xSYOTOSx/EPHSX601/README.md

# EPHSX601

This is a repository for the EPHSX601 project, which is an Arduino-based program designed to control a set of LED boards using a custom protocol over serial communication.
