xSYOTOSx/EPHSX601/EPHSX601_FinalP.pdf

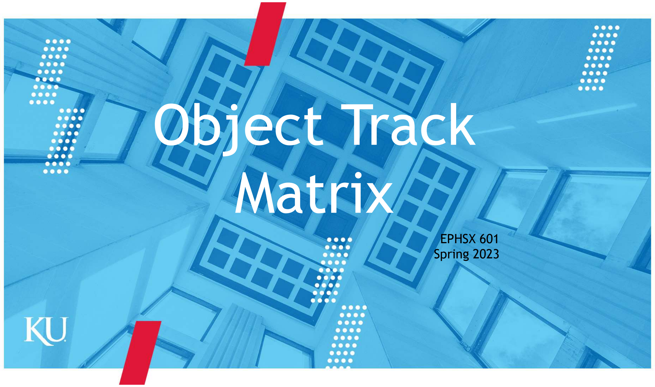
[picture p3: page 1]

# Object Track Matrix

EPHSX 601
Spring 2023

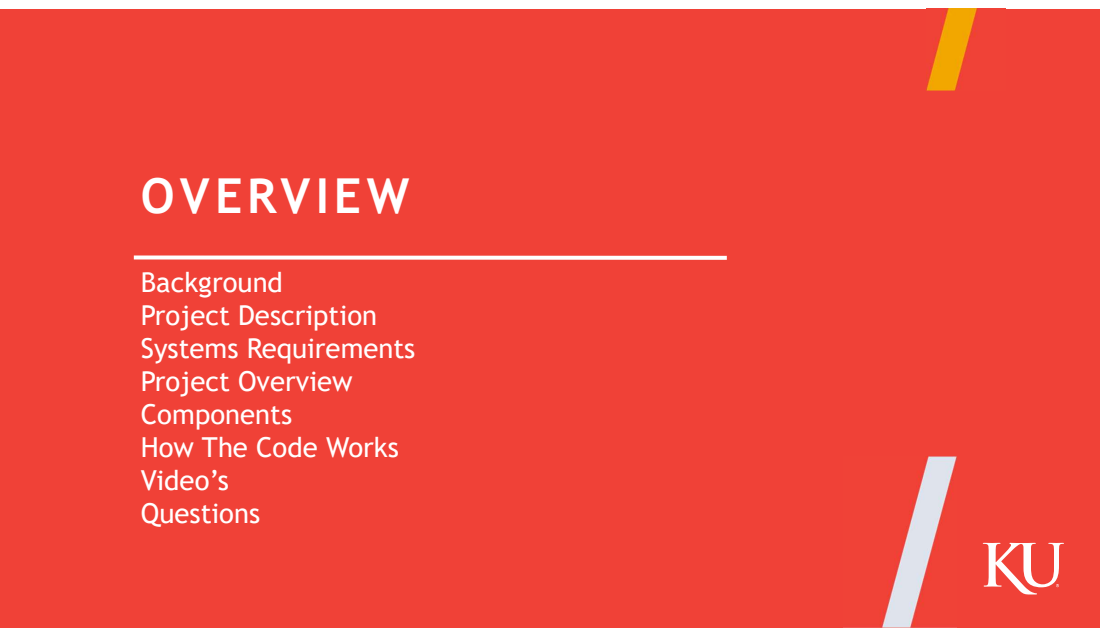
[picture p4: page 2]
OVERVIEW

Background
Project Description
Systems Requirements
Project Overview
Components
How The Code Works
Video’s
Questions

•••••••••••••••••••••••••••••••••

# Back Ground

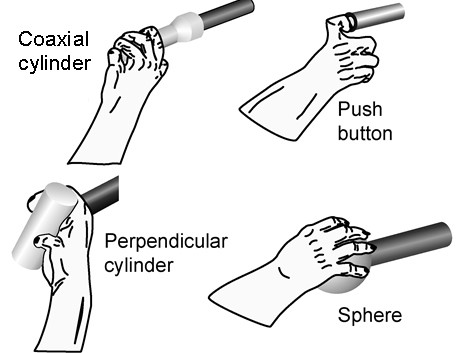
[picture p5: figure]

- Dr. Adam Rouse: Professor of Neurosurgery at the
University of Kansas
Medical Center
- Research Into Reaching & Grasping

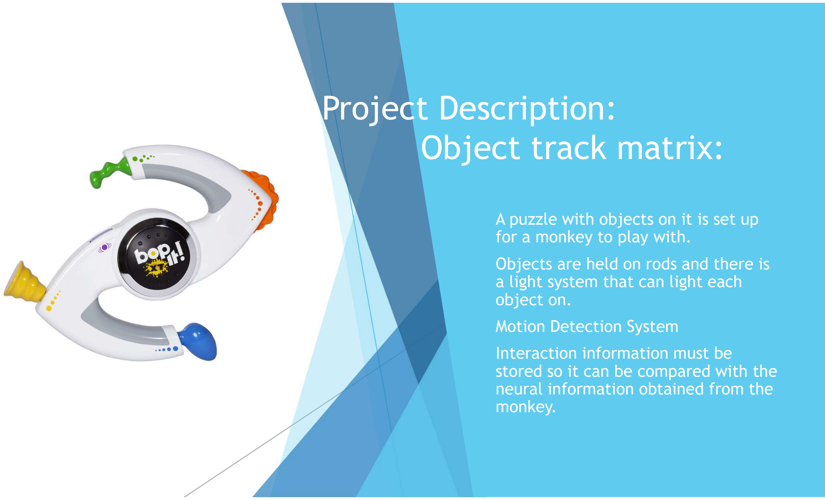
[picture p6: page 4]

•••••••••••••••••••••••••••••••••

# Project Description: Object track matrix:

- A puzzle with objects on it is set up for a monkey to play with.
- Objects are held on rods and there is a light system that can light each object on.
- Motion Detection System
- Interaction information must be stored so it can be compared with the neural information obtained from the monkey.

•••••••••••••••••••••••••••••••••

# System Requirements

- Controllable Object Lighting
- 3 x 4 grid of 12 objects (in about an 18 x 12 inch workspace)
- Preferred to be used flat on a table top
- Flexibility to be able to vary the size and shape of the objects as well as potentially color, weight, and texture.
- The objects need to be anchored to a rod or support, so they stay at a fixed location.
- Design should allow for future flexibility with freely movable objects.
- Should allow for easy cleaning.
- Creation of a task software to control what object is instructed and then determine if the correct object was manipulated.

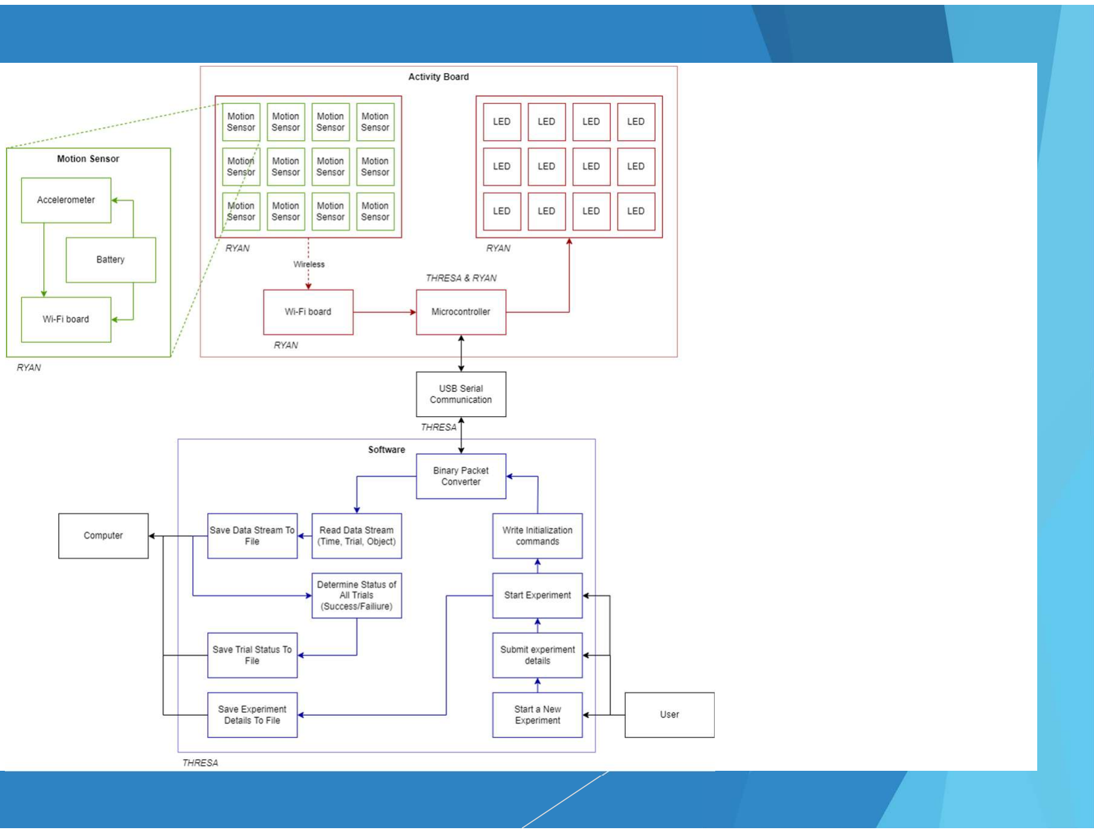
[picture p7: figure]

•••••••••••••••••••••••••••••••••

•••••••••••••••••••••••••••••••••

## Object Track Matrix: Data Flow

# MPU 6050

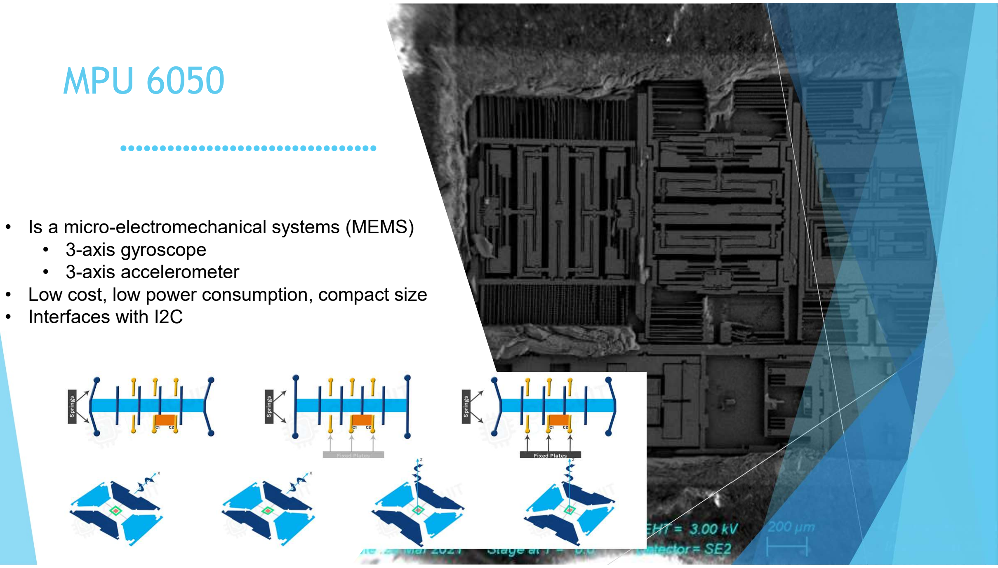
[picture p8: page 8]

•••••••••••••••••••••••••••••••••

- Is a micro-electromechanical systems (MEMS)
- 3-axis gyroscope
- 3-axis accelerometer
- Low cost, low power consumption, compact size
- Interfaces with I2C

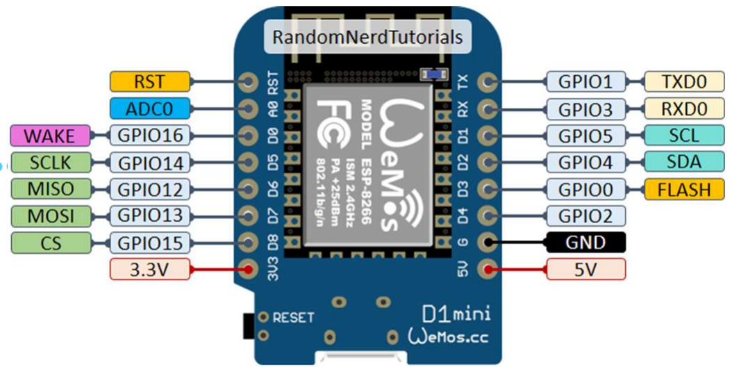
[picture p9: figure]

•••••••••••••••••••••••••••••••••

# D1 Mini

- The WeMos D1 mini is a
Wifi microcontroller
development board.
- Biased on the ESP8266
- Compatible with the
Arduino IDE
- Utilized in a lot of DIY Internet of Things
projects
- Lots of compatible
shields

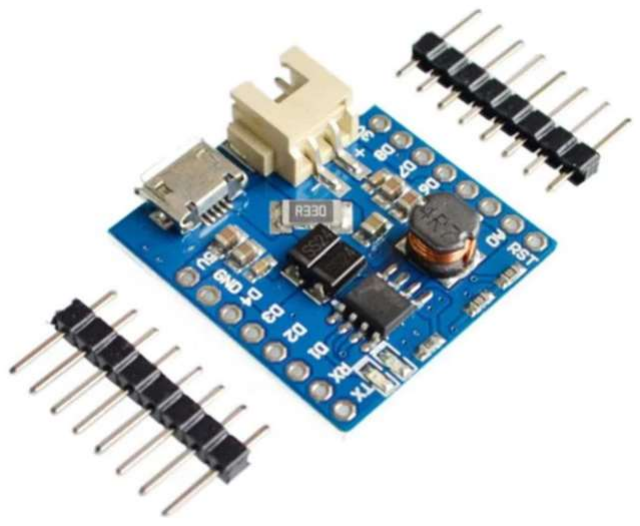
[picture p10: figure]

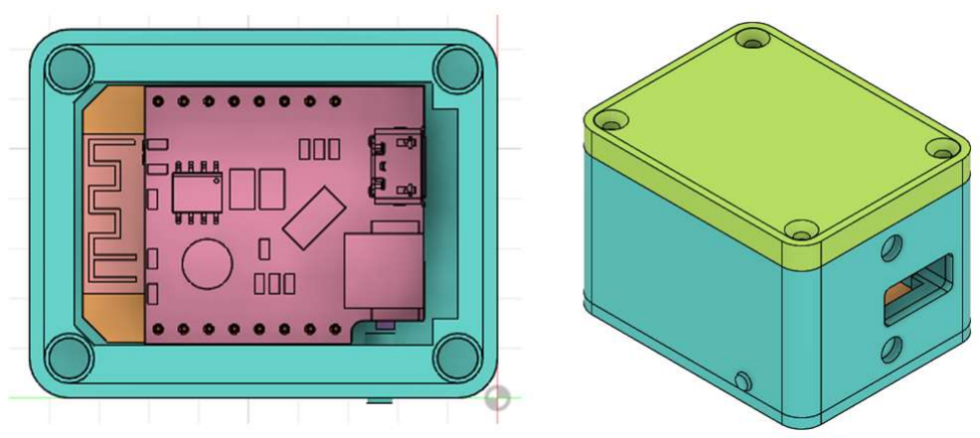
[picture p11: figure]

# Sensor Case

- Battery 320 mAh LiPo
- Approx. 3 hr Battery
Life

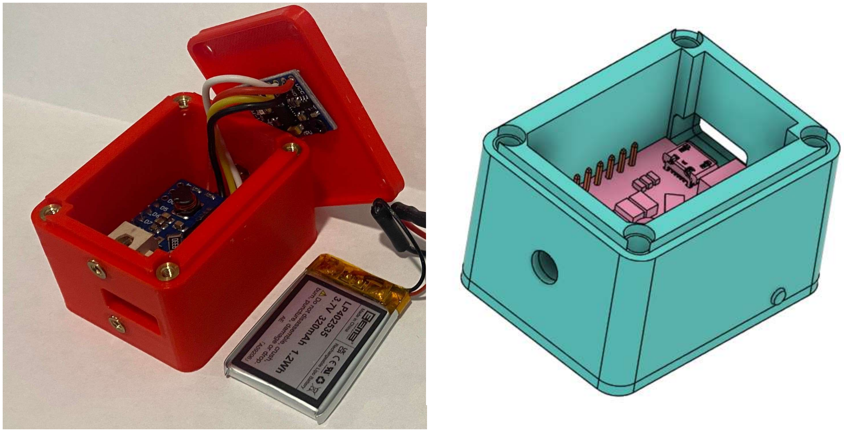
[picture p12: figure]

# Rod Attachment

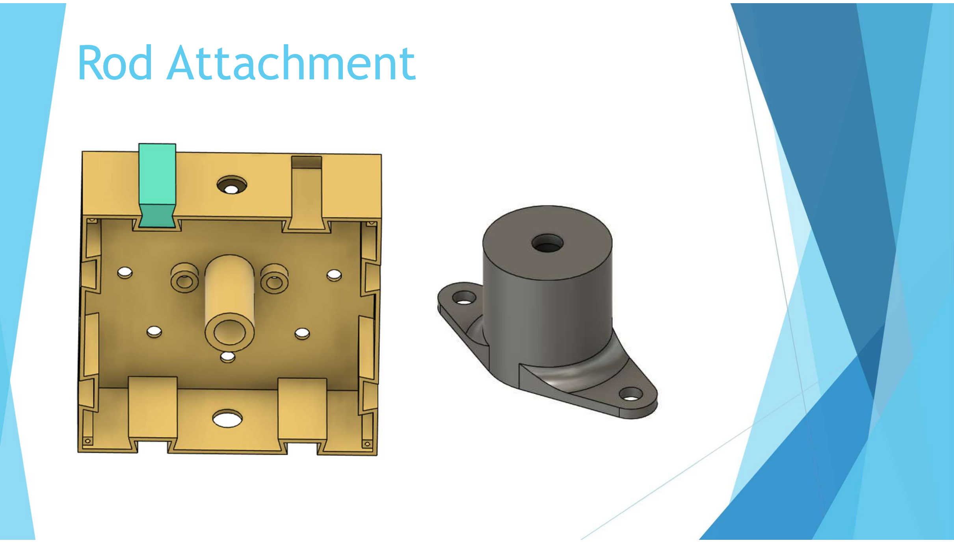
[picture p13: page 11]

•••••••••••••••••••••••••••••••••

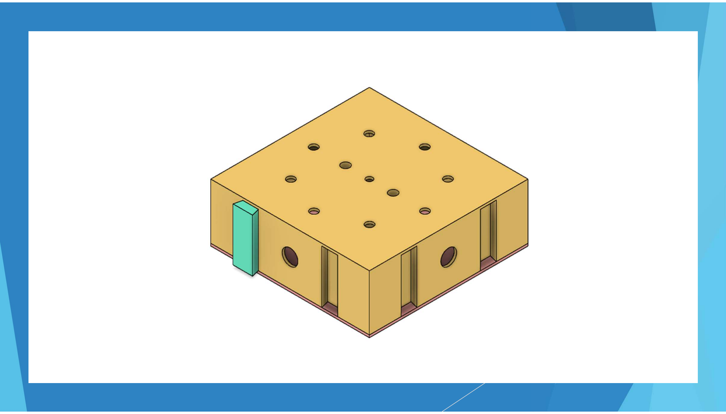
[picture p14: page 12]

•••••••••••••••••••••••••••••••••

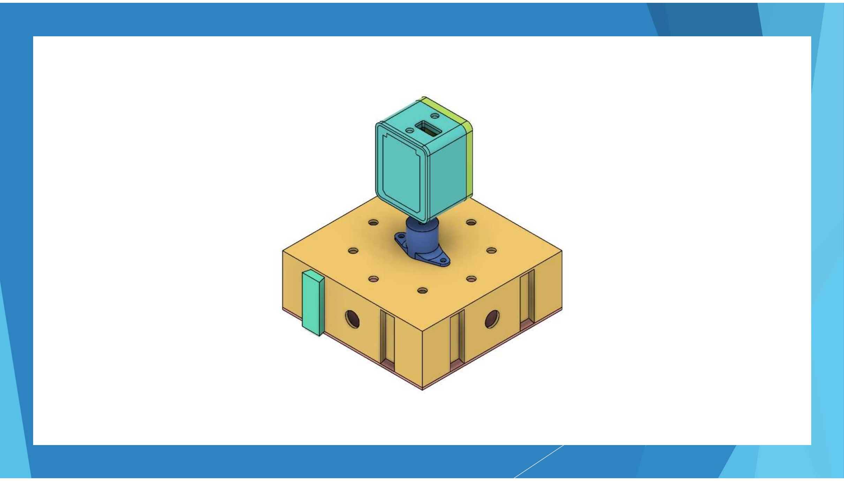
[picture p15: page 13]

•••••••••••••••••••••••••••••••••

•••••••••••••••••••••••••••••••••

# ESP-NOW

- ESP-Now is a wireless communication protocol for fast and reliable communication between ESP32 and ESP8266 microcontrollers without the need for Wi-Fi or Bluetooth.
- It operates on the 2.4 GHz band and uses a simple, lightweight protocol that is ideal for low-power applications.
- ESP-Now is designed for
- low latency
- high reliability
- low power consumption

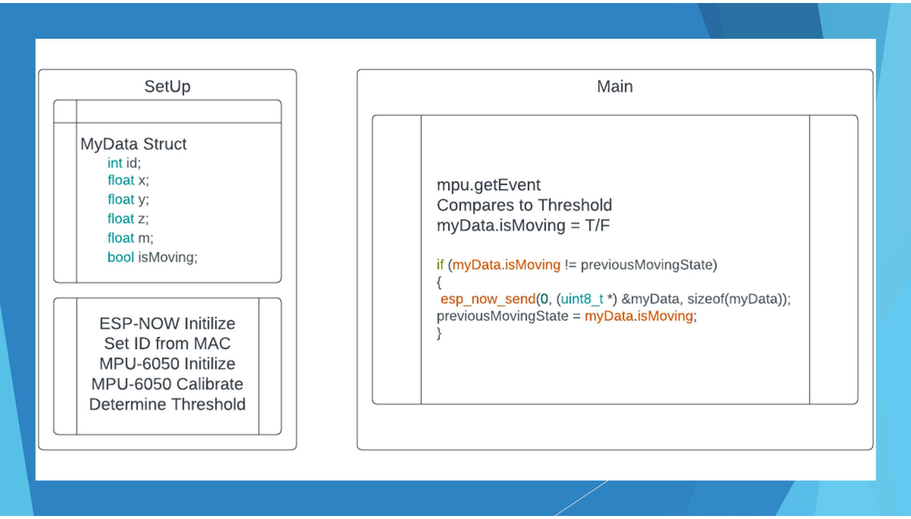
[picture p16: page 15]

•••••••••••••••••••••••••••••••••

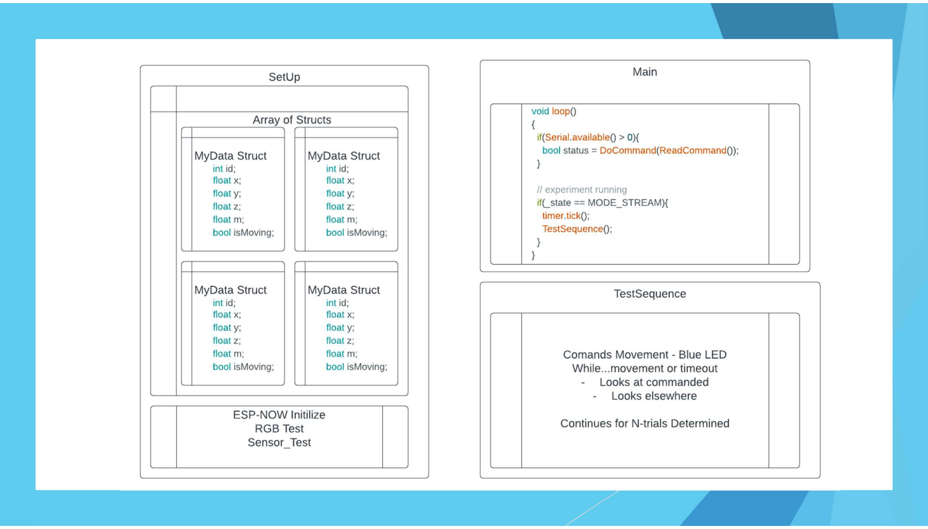
[picture p17: page 16]

•••••••••••••••••••••••••••••••••

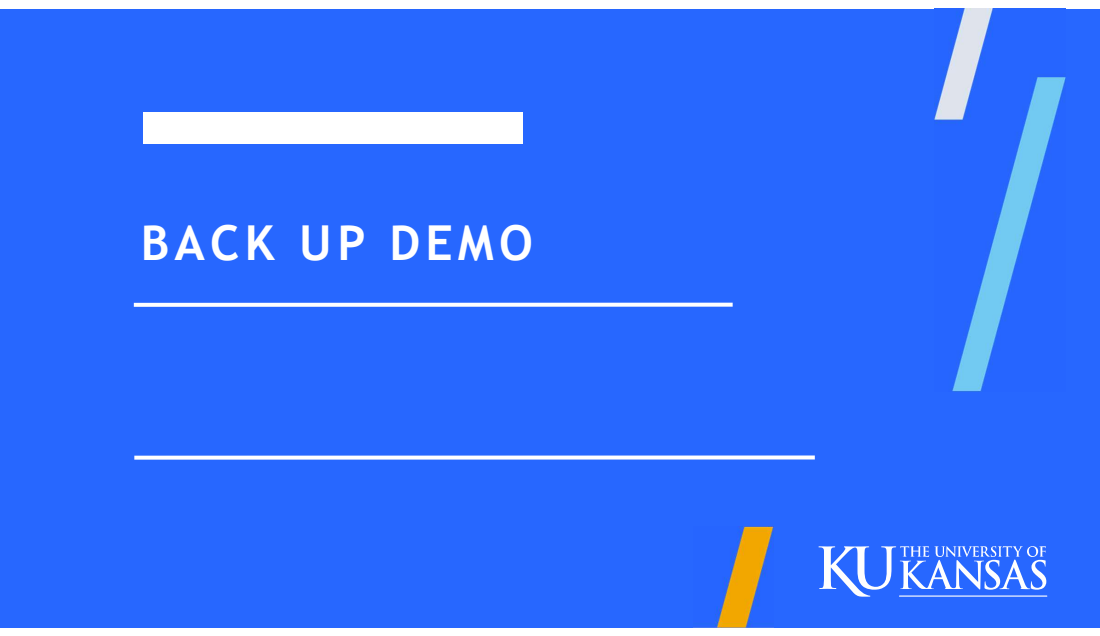
[picture p18: page 17]

BACK UP DEMO

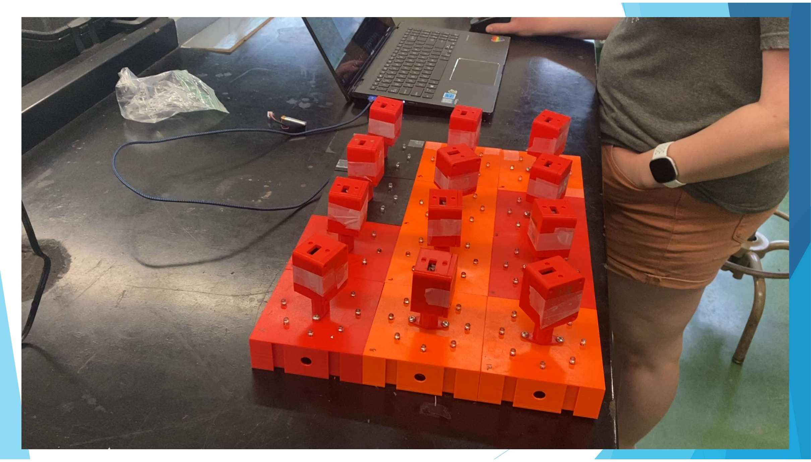
[picture p19: page 18]

••••••••••

# Fun With Accelerometers

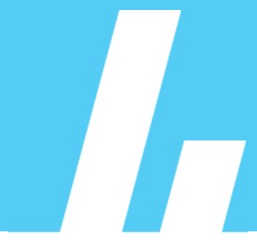
[picture p20: figure]

chrome://flags

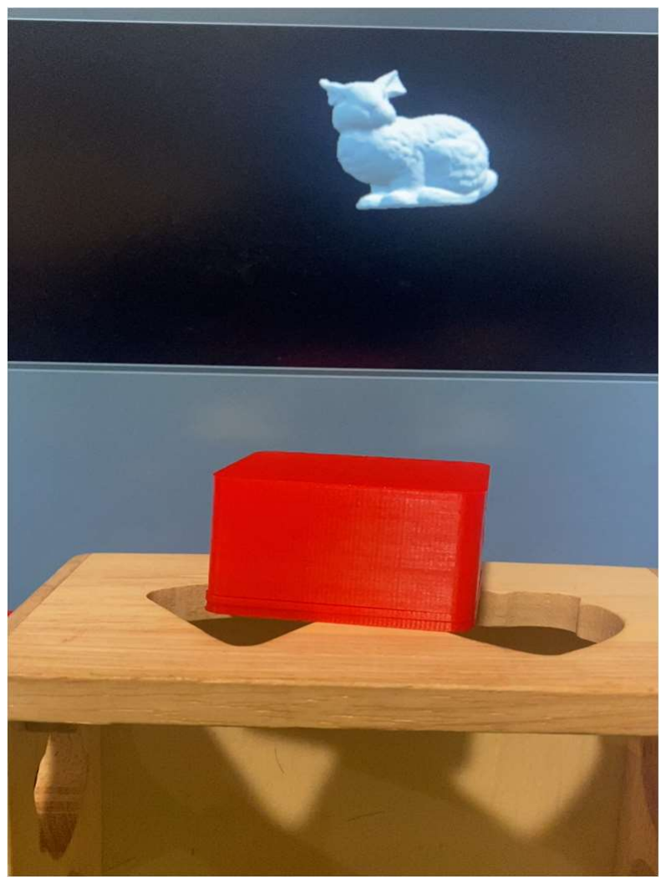
[picture p21: figure]

Experimental Web Platform features https://adafruit.github.io/Adafruit_WebSerial_3DModelViewer/

# Improvements

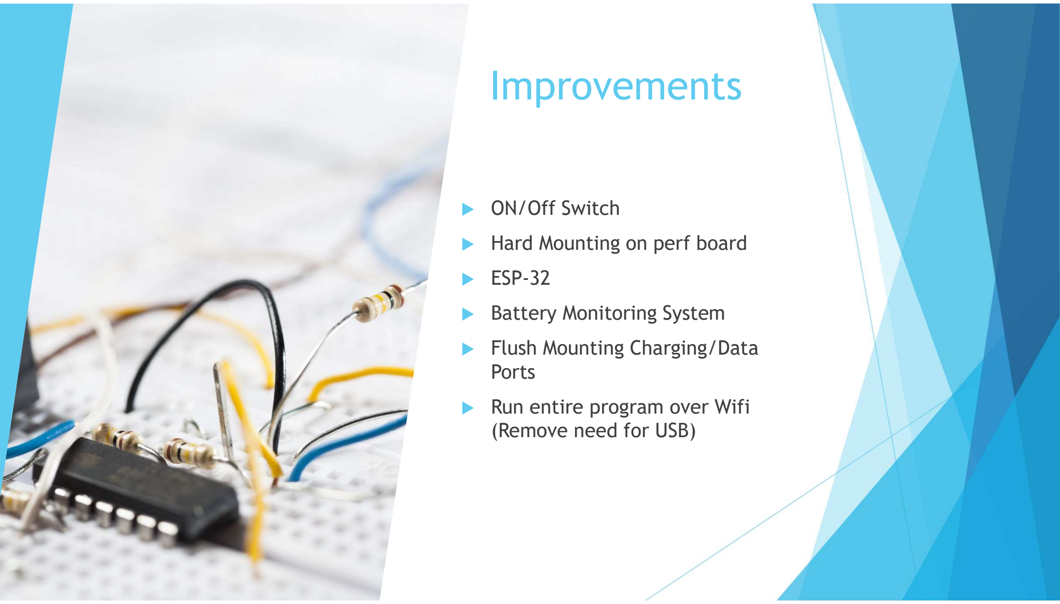
[picture p22: page 21]

•••••••••••••••••••••••••••••••••

- ON/Off Switch
- Hard Mounting on perf board
- ESP-32
- Battery Monitoring System
- Flush Mounting Charging/Data Ports
- Run entire program over Wifi (Remove need for USB)

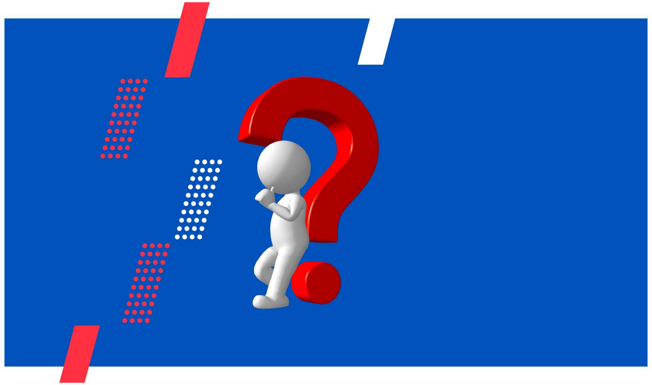
[picture p23: page 22]
