xSYOTOSx/EPHSX601/3D Print Files/Case_Base.stl

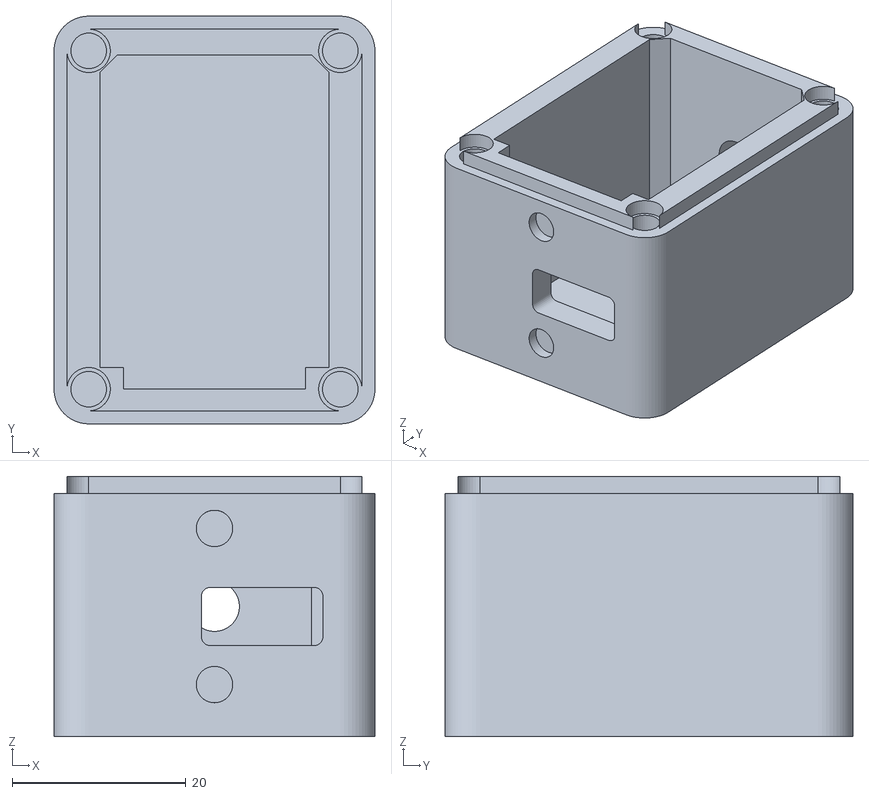
[picture p24: CAD file, 2023-05-12]
3D Print Files/Case_Base.stl
37.0 x 47.0 x 30.0
