xSYOTOSx/EPHSX601/3D Print Files/Base_box_Lid.stl

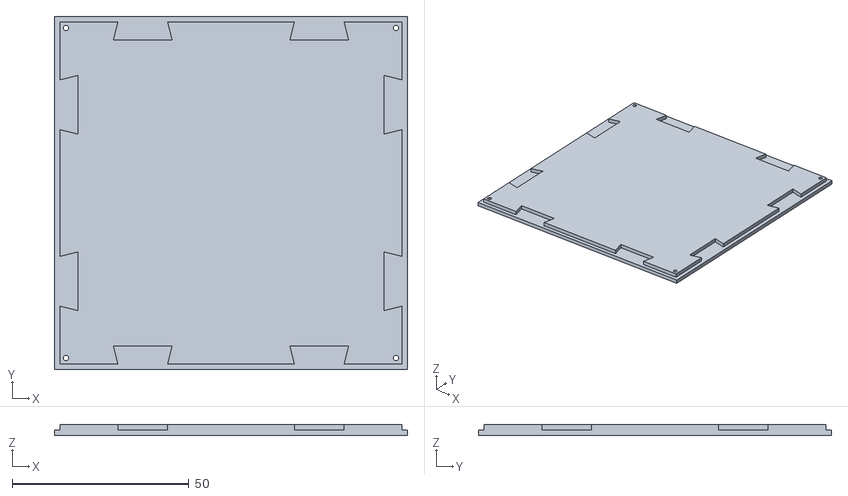
[picture p25: CAD file, 2023-05-12]
3D Print Files/Base_box_Lid.stl
100.0 x 100.0 x 3.00
