xSYOTOSx/EPHSX601/3D Print Files/Rod_Shroud_short.stl

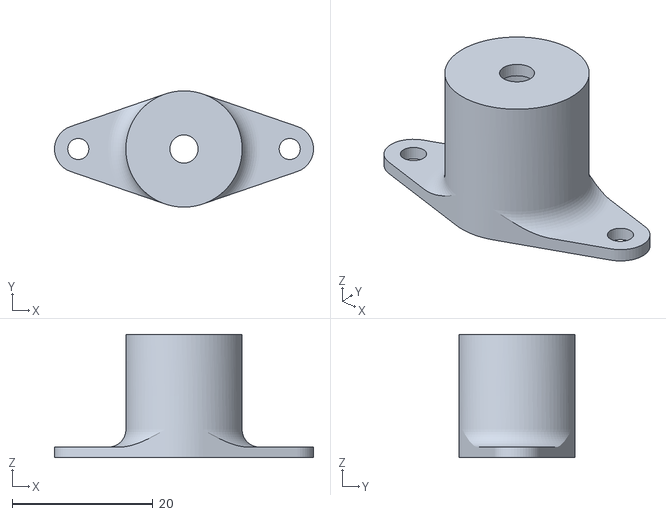
[picture p26: CAD file, 2023-05-12]
3D Print Files/Rod_Shroud_short.stl
36.8 x 16.5 x 17.5
