xSYOTOSx/EPHSX601/3D Print Files/Base_Dovetail.stl

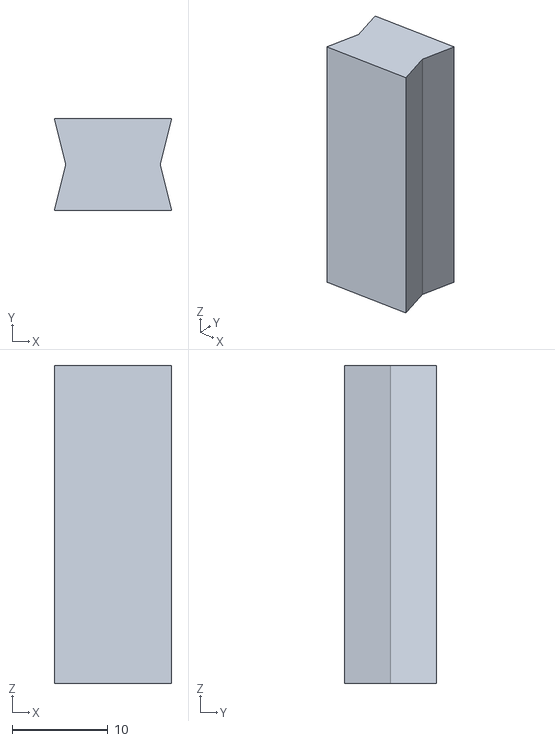
[picture p27: CAD file, 2023-05-12]
3D Print Files/Base_Dovetail.stl
12.3 x 9.60 x 33.3
