xSYOTOSx/EPHSX601/3D Print Files/Base_box.stl

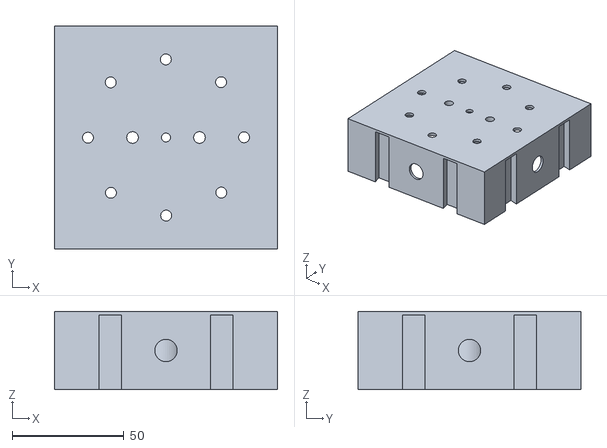
[picture p28: CAD file, 2023-05-12]
3D Print Files/Base_box.stl
100.0 x 100.0 x 35.0
