xSYOTOSx/EPHSX601/3D Print Files/Case_Top.stl

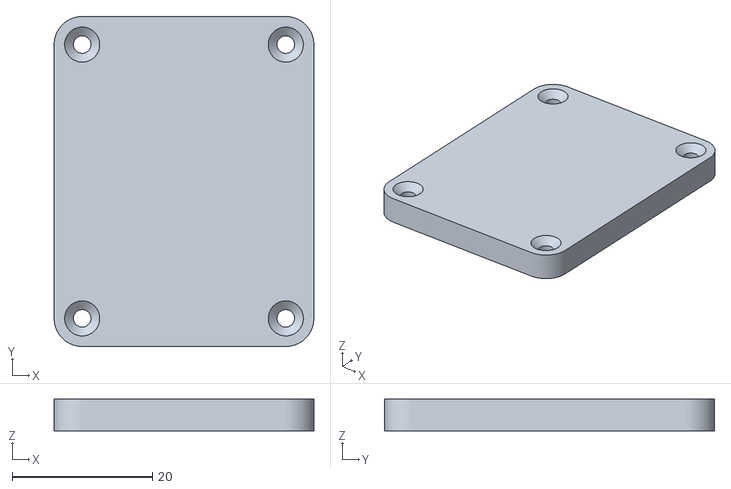
[picture p29: CAD file, 2023-05-12]
3D Print Files/Case_Top.stl
37.0 x 47.0 x 4.50
