xSYOTOSx/EPHSX601/3D Print Files/Rod_Shroud_Lid.stl

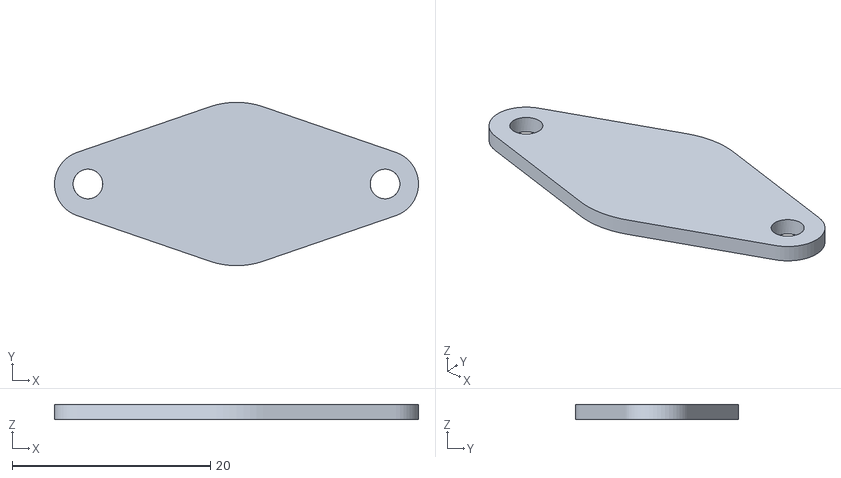
[picture p30: CAD file, 2023-05-12]
3D Print Files/Rod_Shroud_Lid.stl
36.8 x 16.5 x 1.50
