xSYOTOSx/EPHSX601/3D Print Files/Case_Button.stl

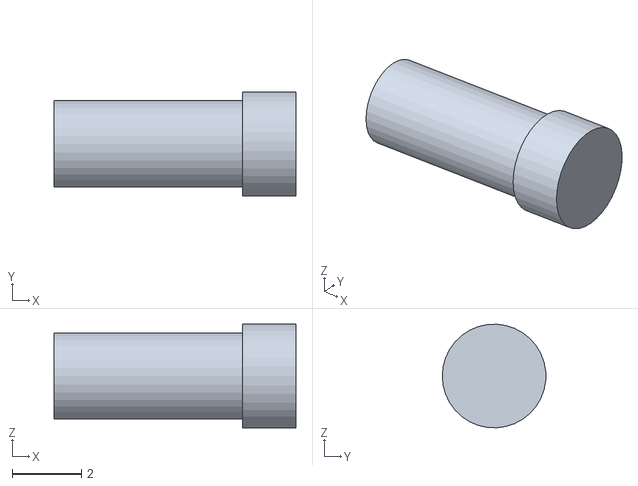
[picture p31: CAD file, 2023-05-12]
3D Print Files/Case_Button.stl
7.00 x 2.99 x 3.00
