xSYOTOSx/EPHSX601/Base Drawing .pdf

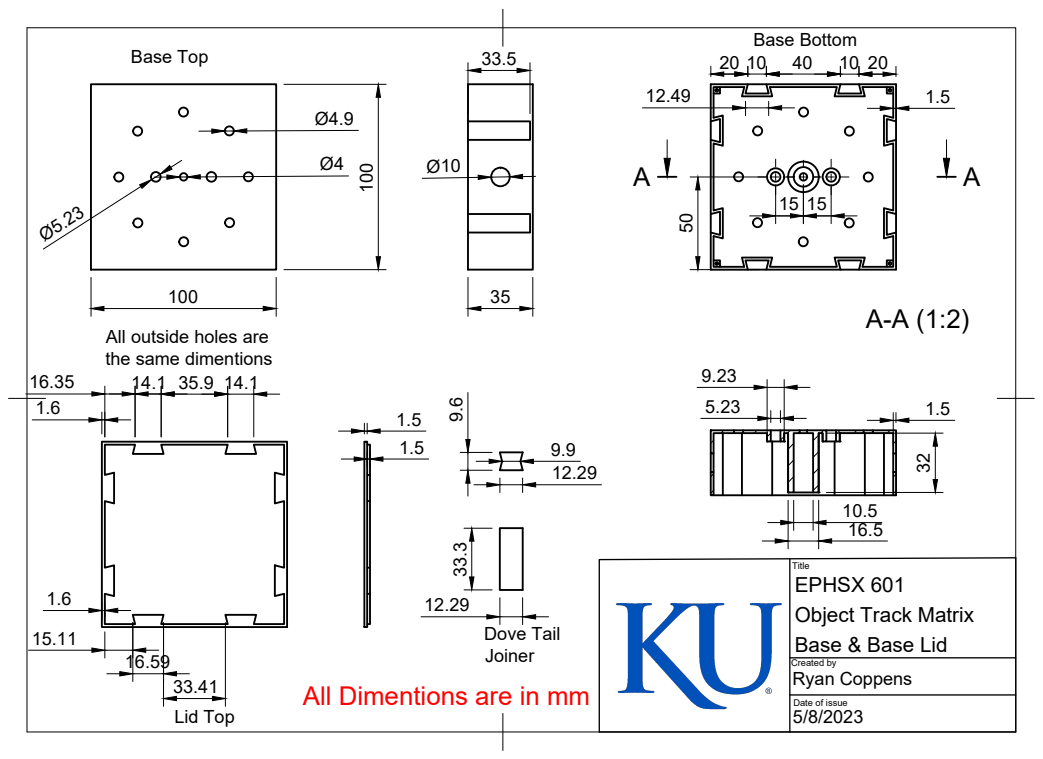
[picture p32: page 1]
Created by Ryan Coppens; Base Bottom; Base Top; Lid Top; Dove Tail

All outside holes are
the same dimentions

Title
EPHSX 601
Object Track Matrix
Base & Base Lid

All Dimentions are in mm

Date of issue
