xSYOTOSx/EPHSX601/Case Drawing .pdf

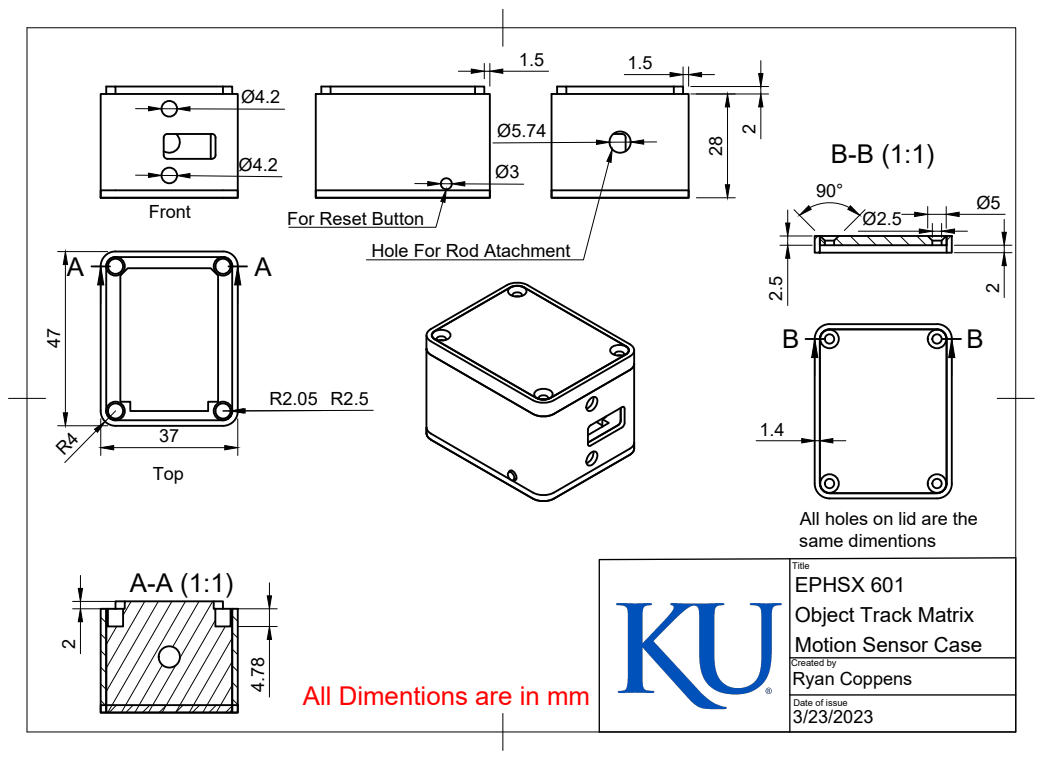
[picture p33: page 1]
Created by Ryan Coppens; Front; For Reset Button

Hole For Rod Atachment

All holes on lid are the
same dimentions

Title
EPHSX 601
Object Track Matrix
Motion Sensor Case

All Dimentions are in mm

Date of issue
