xSYOTOSx/EPHSX601/Rod Drawing.pdf

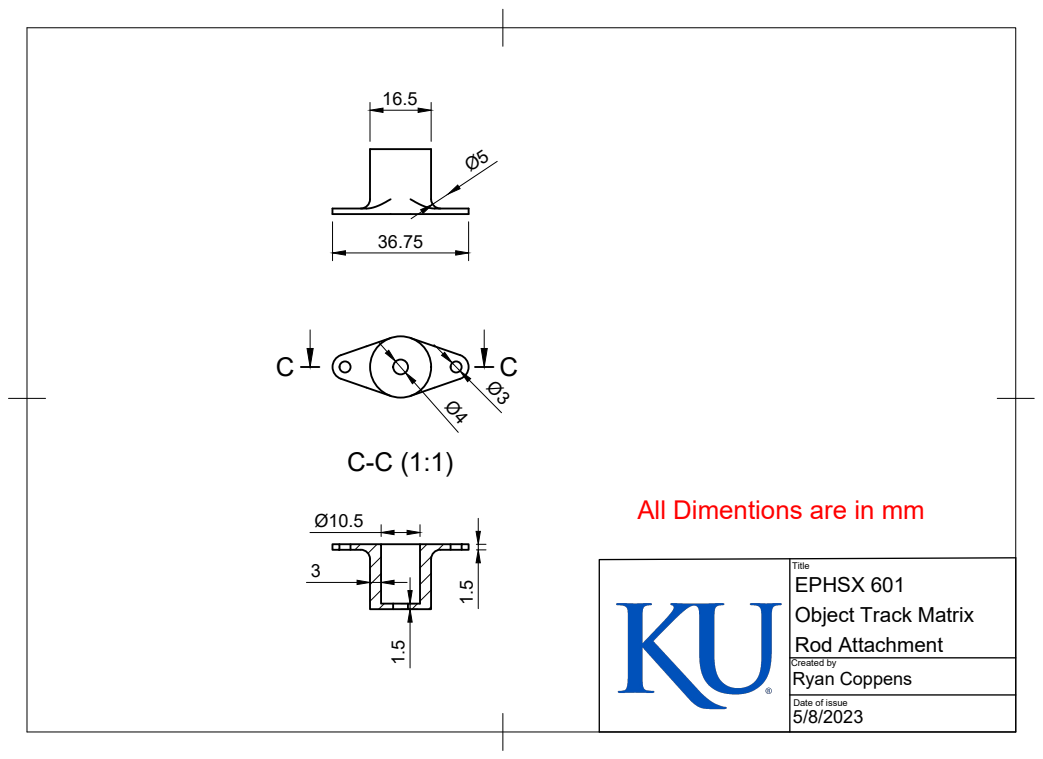
[picture p34: page 1]
Created by Ryan Coppens

All Dimentions are in mm

Title
EPHSX 601
Object Track Matrix
Rod Attachment

Date of issue
