xSYOTOSx/EPHSX601/(commit log)

2023-04-07 all 13 or so sensors are made
2023-04-21 added a self calibratin function and then sets the threshold movement from that calibration
2023-04-28 added some changes to LED code and added a quick test function
2023-04-28 finished LED Test with correct pins
    [LED_Testing.ino]
2023-05-04 merged code and added accelerometer test
2023-05-05 removed Serial prints
